aungzaymyo04/8bitconverter/Photo/Image (3).jpg

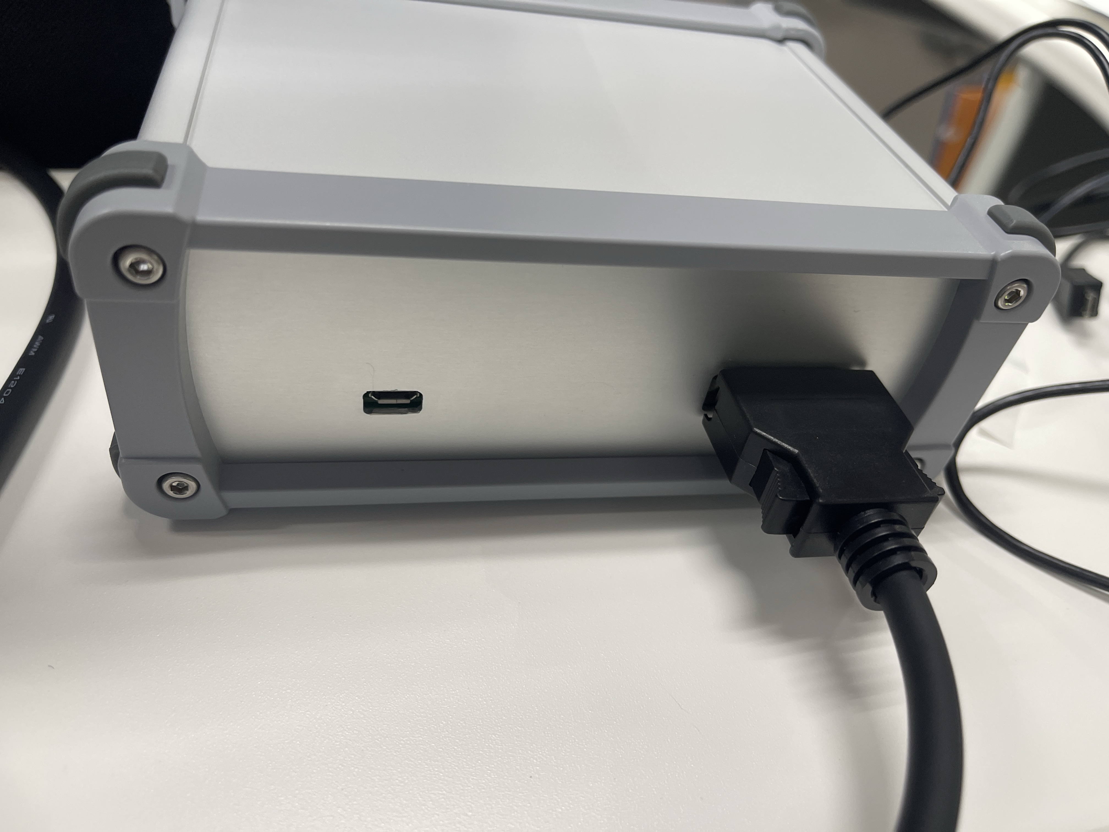
Photo/Image (3).jpg
