aungzaymyo04/8bitconverter/Photo/Image (2).jpg

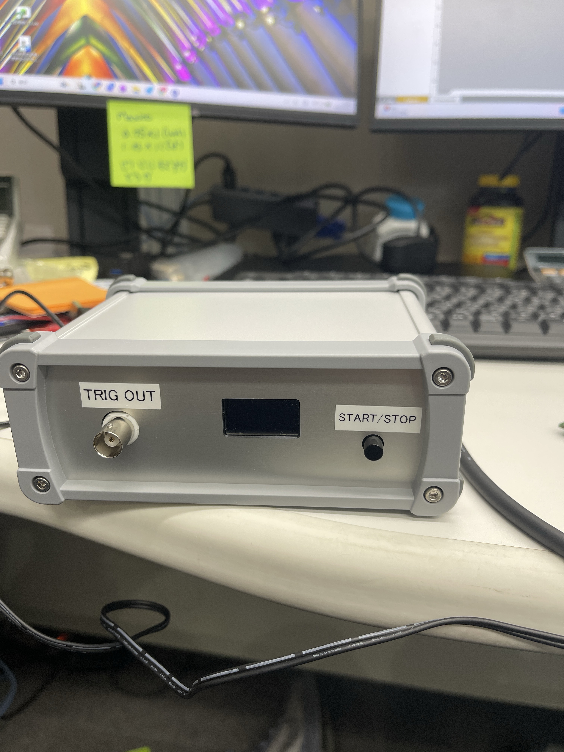
Photo/Image (2).jpg
