aungzaymyo04/8bitconverter/Photo/Image (1).jpg

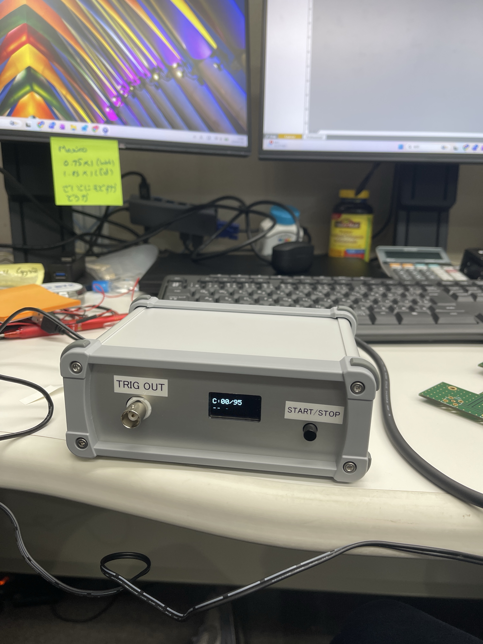
Photo/Image (1).jpg
