aungzaymyo04/8bitconverter/Photo/Image (4).jpg

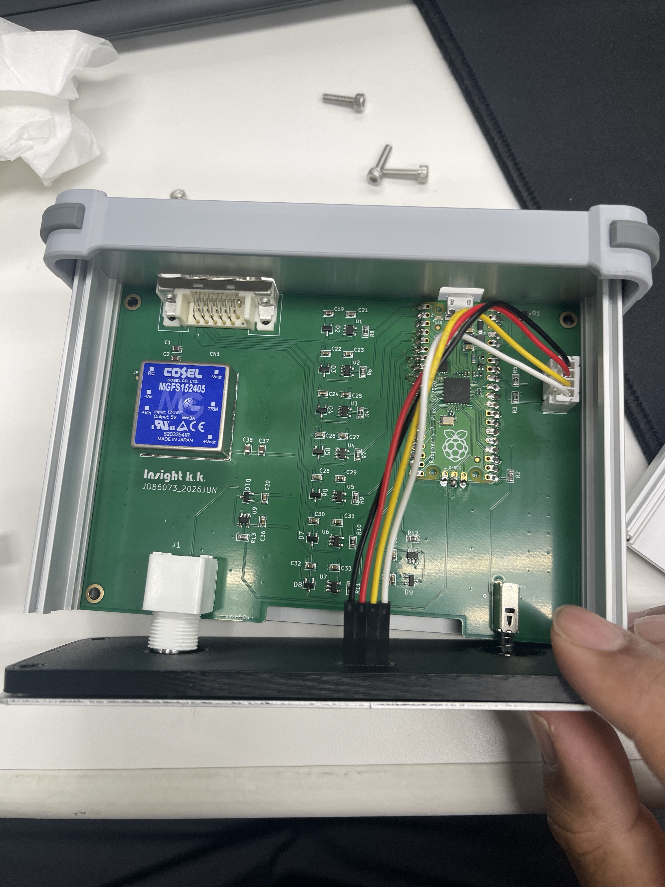
Photo/Image (4).jpg
