aungzaymyo04/8bitconverter/3d_data.step

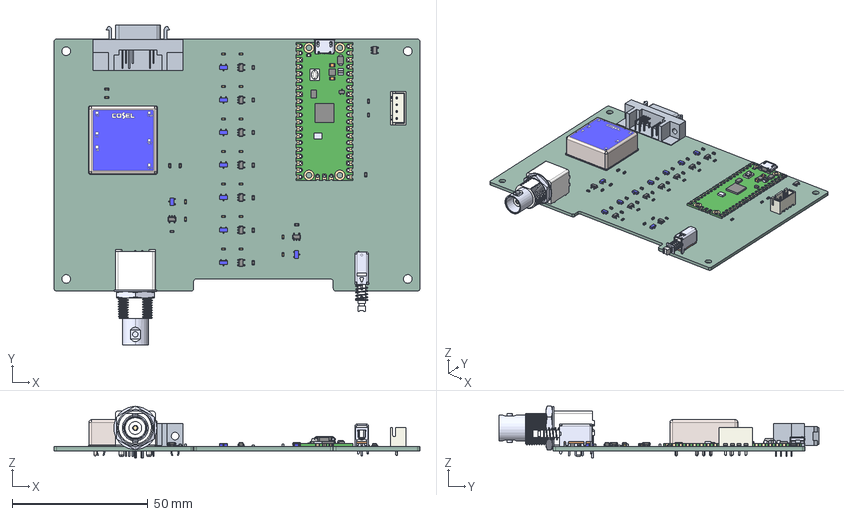
[picture p5: CAD file, 2026-07-07]
3d_data.step
135.0 x 118.1 x 19.1 mm
term1 x 12
term2 x 12
SC0915
CONBNC002
DBV5A x 9
JST_B4B_XH_A
S-Mini x 9
PinsArrayL
PinsArrayR
PN11SHNA03QE
MGS15
a0p7F880mqrg
8bit converter_PCB
