aungzaymyo04/8bitconverter/Drawing/front_panel_filler.stl

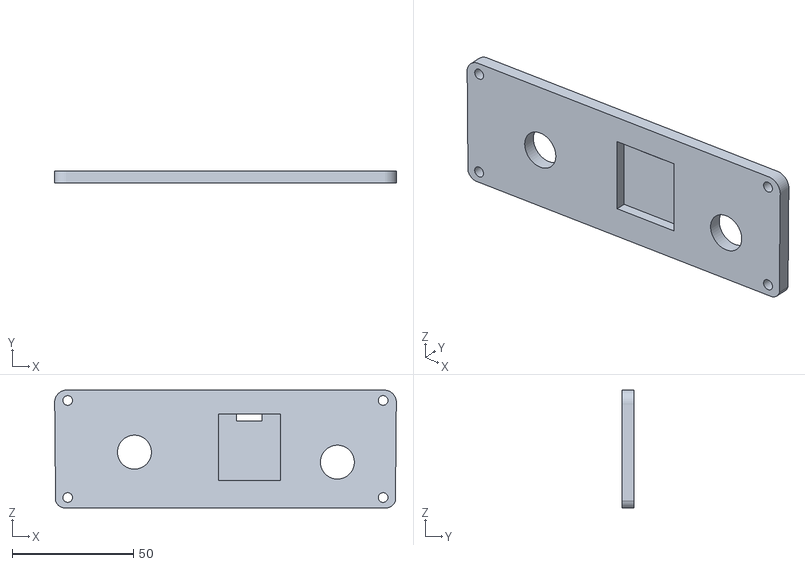
[picture p6: CAD file, 2026-07-14]
Drawing/front_panel_filler.stl
141.0 x 5.00 x 48.6
