aungzaymyo04/8bitconverter/Drawing/boxfiller_5mm.stl

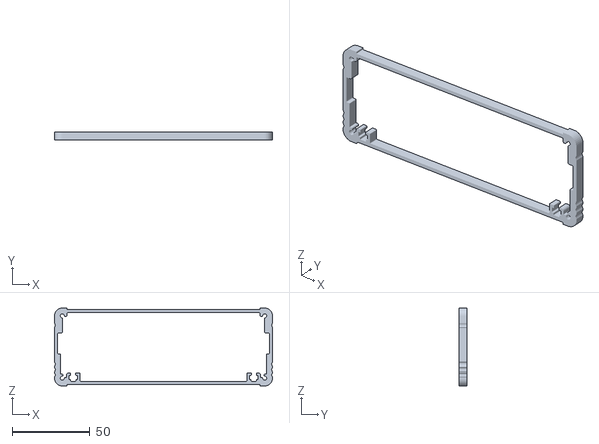
[picture p7: CAD file, 2026-07-09]
Drawing/boxfiller_5mm.stl
140.0 x 5.00 x 50.0
