aungzaymyo04/8bitconverter/Drawing/back_panel_drawing.pdf

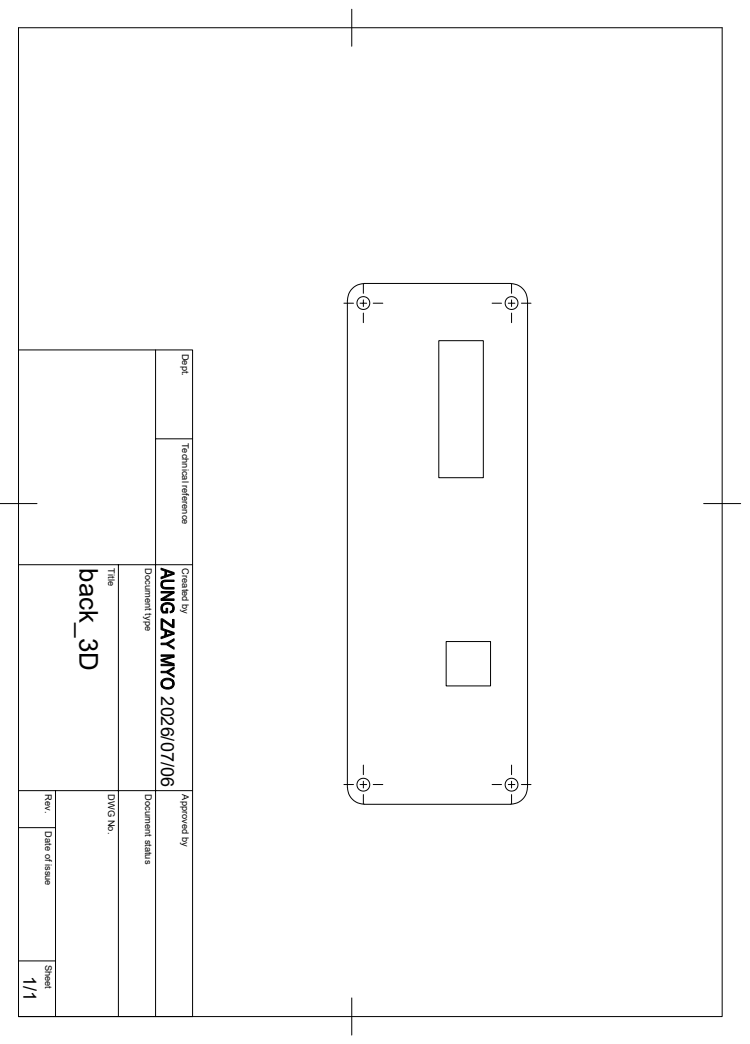
[picture p8: page 1]

Dept. Technical reference Created by Approved by Title DWG No. Document type Document status Rev. Date of issue Sheet 2026/07/06 1/1 back_3D
