aungzaymyo04/8bitconverter/8bit converter.kicad_pcb

## KiCad design 8bit converter.kicad_pcb (2026-07-07)

Schematic: 8bit converter.kicad_sch

Parts:
C1, C2: 10uf; CAP1608m
C19, C20, C21, C22, C23, C24, C25, C26, C27, C28, C29, C30, C31, C32, C33, C34, C35, C36: 0.1uF; CAP1608m
C37, C38: 10uF; CAP1608m
CN1: 10220-55G3PC
CN2: B4B-XH-A
D1: RB496EATR; Mouser Part Number 755-RB496EATR
D2, D3, D4, D5, D6, D7, D8, D9, D10: 1SS226
J1: CONBNC002
JP1: PAD_Short
MH1, MH2, MH3, MH4: HOLE_M3
PS1: MGS151205; Mouser Part Number 436-MGS151205
R2, R3, R5: 2.2k; REG1608m
R4, R6, R7, R8, R9, R10, R11, R12, R13: 10k; REG1608m
SW1: PN11SHNA03QE
U1, U2, U3, U4, U5, U6, U7, U8, U9: SN74LV1T34DBVR
U10: SC0915

Connections:
+3.3V: R2.2, R3.2, R5.2, U10.36 (3V3_OUT)
+5V: C19.2, C20.2, C21.2, C22.1, C23.2, C24.2, C25.1, C26.1, C27.2, C28.1, C29.2, C30.1, C31.2, C32.1, C33.2, C34.1, C35.2, C36.1, C37.1, C38.1, CN2.3, D1.4 (K_2), D2.2, D3.2, D4.2, D5.2, D6.2, D7.2, D8.2, D9.2, D10.2, PS1.4 (+VOUT), U1.5 (VCC), U2.5 (VCC), U3.5 (VCC), U4.5 (VCC), U5.5 (VCC), U6.5 (VCC), U7.5 (VCC), U8.5 (VCC), U9.5 (VCC), U10.39 (VSYS)
/+12V: C1.2, C2.2, CN1.9, CN1.19, PS1.3 (+VIN)
/SCL: CN2.2, R5.1, U10.32 (GP27)
/SDA: CN2.1, R3.1, U10.31 (GP26)
/o_5V_MUX0: CN1.14, D2.3, U1.4 (Y)
/o_5V_MUX1: CN1.4, D3.3, U2.4 (Y)
/o_5V_MUX2: CN1.13, D4.3, U3.4 (Y)
/o_5V_MUX3: CN1.3, D5.3, U4.4 (Y)
/o_5V_MUX4: CN1.12, D6.3, U5.4 (Y)
/o_5V_MUX5: CN1.2, D7.3, U6.4 (Y)
/o_5V_MUX6: CN1.11, D8.3, U7.4 (Y)
/o_5V_MUX7: CN1.1, D9.3, U8.4 (Y)
/o_MUX0: R8.1, U1.2 (A), U10.1 (GP0(UART_TX))
/o_MUX1: R6.1, U2.2 (A), U10.2 (GP1(UART_RX))
/o_MUX2: R4.1, U3.2 (A), U10.4 (GP2(SPI0_SCK))
/o_MUX3: R7.1, U4.2 (A), U10.5 (GP3(SPI0_TX))
/o_MUX4: R9.1, U5.2 (A), U10.6 (GP4(SPI0_RX)(UART1TX))
/o_MUX5: R10.1, U6.2 (A), U10.7 (GP5(SPI0CSn)(UART1RX))
/o_MUX6: R11.1, U7.2 (A), U10.9 (GP6(UART_TX))
/o_MUX7: R12.1, U8.2 (A), U10.10 (GP7(UART_RX))
/o_TRIG: R13.1, U9.2 (A), U10.11 (GP8(I2C1_SDA))
/o_TRIG_BNC: D10.3, J1.1, U9.4 (Y)
GND: C1.1, C2.1, C19.1, C20.1, C21.1, C22.2, C23.1, C24.1, C25.2, C26.2, C27.1, C28.2, C29.1, C30.2, C31.1, C32.2, C33.1, C34.2, C35.1, C36.2, C37.2, C38.2, CN1.7, CN1.17, CN1.MH1, CN1.MH2, CN2.4, D2.1, D3.1, D4.1, D5.1, D6.1, D7.1, D8.1, D9.1, D10.1, J1.2, J1.S1, J1.S2, JP1.1, MH1.1 (1_1), MH2.1 (1_1), MH3.1 (1_1), MH4.1 (1_1), PS1.2 (-VIN), PS1.6 (-VOUT), R4.2, R6.2, R7.2, R8.2, R9.2, R10.2, R11.2, R12.2, R13.2, SW1.1 (NO), U1.3 (GND), U2.3 (GND), U3.3 (GND), U4.3 (GND), U5.3 (GND), U6.3 (GND), U7.3 (GND), U8.3 (GND), U9.3 (GND), U10.3 (GND), U10.8 (GND), U10.13 (GND), U10.18 (GND), U10.23 (GND), U10.28 (GND), U10.33 (AGND), U10.38 (GND), U10.D2 (GND)
unnamed: D1.3 (A_2), U10.40 (VBUS)
unnamed: JP1.2, PS1.1 (RC)
unnamed: R2.1, SW1.2 (COM), U10.21 (GP16)

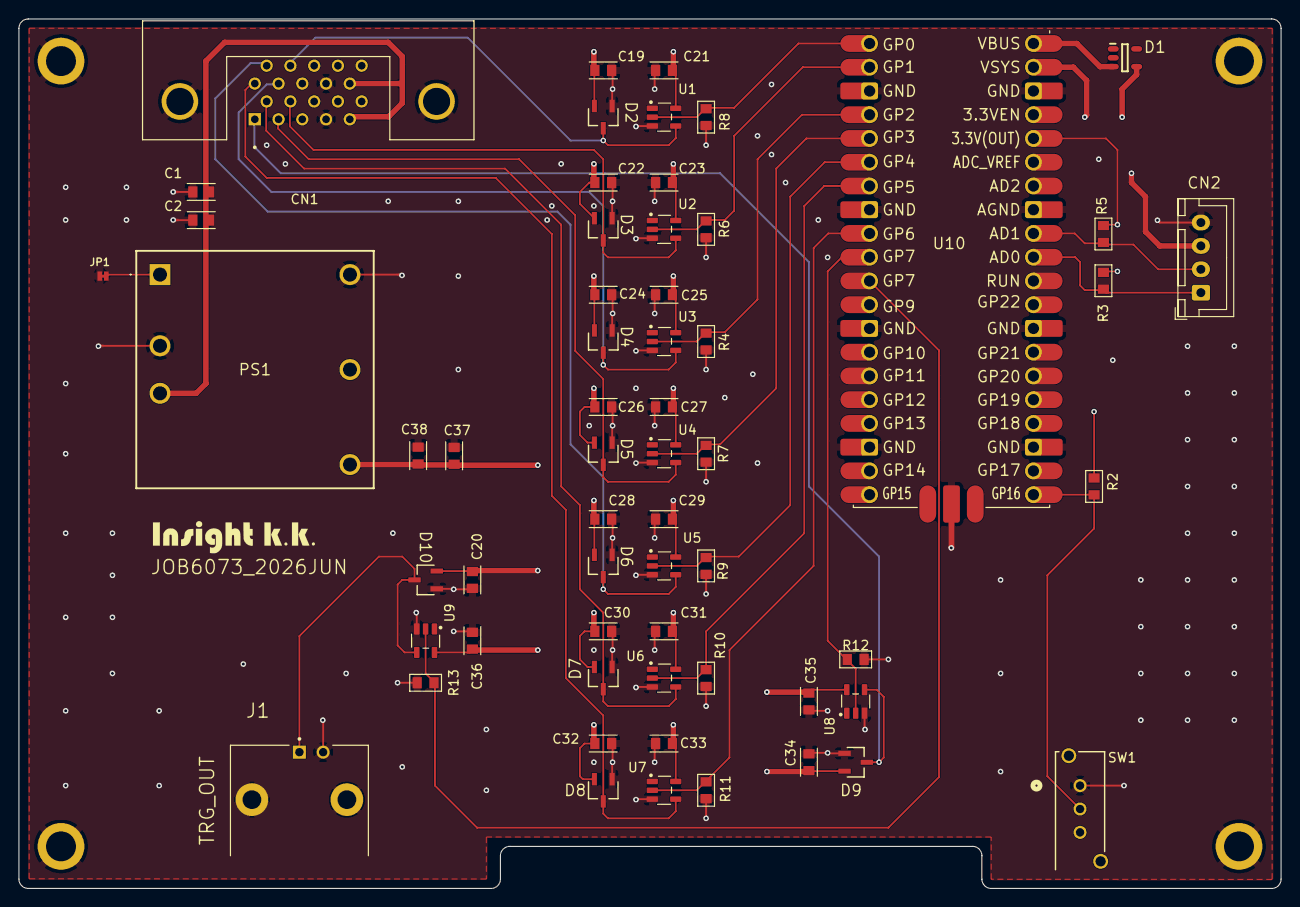
[picture p9: board 8bit converter.kicad_pcb from above]

Board: 4 copper layers, 135.0 x 93.0 mm, 65 parts (0 on the bottom side), 27 nets.

Other parts of the board:
${REFERENCE}: ${VALUE}; Logo_S
