aungzaymyo04/8bitconverter/pipico/main.py

from machine import Pin, I2C
import ssd1306
import time
import json  

trg_pin = Pin(8, Pin.OUT)
do_pins = [Pin(i, Pin.OUT) for i in range(8)]
button = Pin(16, Pin.IN, Pin.PULL_UP)
MASK_RELEASE_AFTER_SEC = 200

i2c = I2C(1, sda=Pin(26), scl=Pin(27), freq=400000)
display = ssd1306.SSD1306_I2C(128, 64, i2c)

TRIG_TIMER_SEC = 1
PULSE_WIDTH_US = 2000 
COUNT = 0

def clear_all_outputs():
    for pin in do_pins:
        pin.value(0)
    trg_pin.value(0)
    
def large_text(text, x, y, scale=2):
    for i, char in enumerate(text):
        for row in range(8):
            char_buf = bytearray(8)
            fb = ssd1306.framebuf.FrameBuffer(char_buf, 8, 8, ssd1306.framebuf.MONO_VLSB)
            fb.text(char, 0, 0, 1)
            
            for col in range(8):
                if fb.pixel(col, row):
                    for sy in range(scale):
                        for sx in range(scale):
                            display.pixel(x + (i * 8 * scale) + (col * scale) + sx, 
                                          y + (row * scale) + sy, 1)

def update_display(status_text, current_count, elapsed_ms):
    total_seconds = int(elapsed_ms / 1000)
    hours = total_seconds // 3600
    minutes = (total_seconds % 3600) // 60
    seconds = total_seconds % 60
    time_str = f"{hours:02d}:{minutes:02d}:{seconds:02d}"

    display.fill(0) 
    display.text(f"STATUS: {status_text}", 0, 0)
    count_str = f"C:{current_count:02d}/95"
    large_text(count_str, x=0, y=16, scale=2)
    large_text(time_str, x=0, y=44, scale=2)
    display.show()

def display_error(error_msg):
    display.fill(0)
    display.text("== ERROR ==", 0, 0)
    display.text("JSON LOAD FAILED", 0, 18)
    display.text(str(error_msg)[:16], 0, 36)
    display.text(str(error_msg)[16:32], 0, 50)
    display.show()

def set_pins_to_count(current_count):
    number = current_count & 0xFF 
    for i in range(8):
        bit_status = (number >> i) & 1
        do_pins[i].value(bit_status)

def trig(elapsed_ms, current_count):
    release_time_ms = MASK_RELEASE_TIME_MS[current_count]
    
    if elapsed_ms >= release_time_ms or elapsed_ms >= (MASK_RELEASE_AFTER_SEC * 1000):
        trg_pin.value(1)
    else:
        trg_pin.value(0)

    set_pins_to_count(current_count)
    time.sleep_us(PULSE_WIDTH_US)
    trg_pin.value(0)

json_success = False
try:
    with open("config.json", "r") as f:
        raw_data = json.load(f)
    MASK_RELEASE_TIME_SEC = {int(k): v for k, v in raw_data.items()}
    MASK_RELEASE_TIME_MS = {k: v * 1000 for k, v in MASK_RELEASE_TIME_SEC.items()}
    print("JSON configuration loaded successfully.")
    json_success = True
except Exception as e:
    print("Failed to load JSON:", e)
    display_error(e)   
    clear_all_outputs() 

if not json_success:
    print("Program halted due to JSON error.")
    while True:
        time.sleep_ms(1000)

running = False
start_time = 0
next_trig_deadline = 0
last_button_state = 1
last_click_time = 0

clear_all_outputs()
print("System Ready. 1-click to Start / Double-click to Stop.")
update_display("READY", 0, 0)

while True:
    current_button_state = button.value()
    now_ms = time.ticks_ms()
    
    if last_button_state == 1 and current_button_state == 0:
        time.sleep_ms(20) 
        if button.value() == 0:
            if not running:
                running = True
                COUNT = 0
                start_time = time.ticks_ms()
                next_trig_deadline = time.ticks_add(start_time, TRIG_TIMER_SEC * 1000)
                clear_all_outputs()
                print("System STARTED")
                last_click_time = now_ms
            else:
                if time.ticks_diff(now_ms, last_click_time) < 500:
                    running = False
                    clear_all_outputs()
                    print("System STOPPED (Double-click)")
                    update_display("STOPPED", COUNT, time.ticks_diff(now_ms, start_time))
                else:
                    print("Click detected (Waiting for second click to stop...)")
                    last_click_time = now_ms

    last_button_state = current_button_state

    if running:
        if time.ticks_diff(now_ms, next_trig_deadline) >= 0:
            elapsed_total_ms = time.ticks_diff(now_ms, start_time)
            current_count = COUNT if COUNT <= 95 else 0
            
            print(f"Count: {current_count}, Elapsed: {elapsed_total_ms} ms")
            
            trig(elapsed_total_ms, current_count)
            update_display("RUNNING", current_count, elapsed_total_ms)
            
            COUNT = (current_count + 1) if (current_count < 95) else 0
            next_trig_deadline = time.ticks_add(next_trig_deadline, TRIG_TIMER_SEC * 1000)

    time.sleep_ms(1)
