aungzaymyo04/8bitconverter/(commit log)

2026-07-09 circuit python
2026-07-14 final add circuit python and photo
    [front_panel_filler.stl]
2026-07-21 shipment add circuit python and photo
